thanassisfrank/pcb-touch-piano/README.md

# pcb-touch-piano

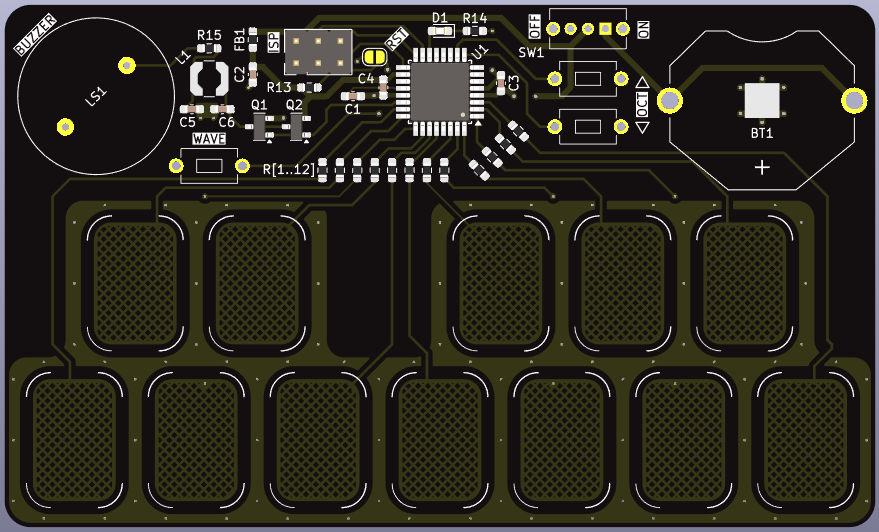
[picture p1: hardware/piano-board/piano-board.png]
The froms side of the pcb


A project to create a small piano style synth on a pcb with capacitive touch input, powered by a coin cell. The MCU is the Atmega328pb with firmware written in C.
