thanassisfrank/pcb-touch-piano/hardware/piano-board/piano-board.kicad_pcb

## KiCad design hardware/piano-board/piano-board.kicad_pcb (2024-12-03)

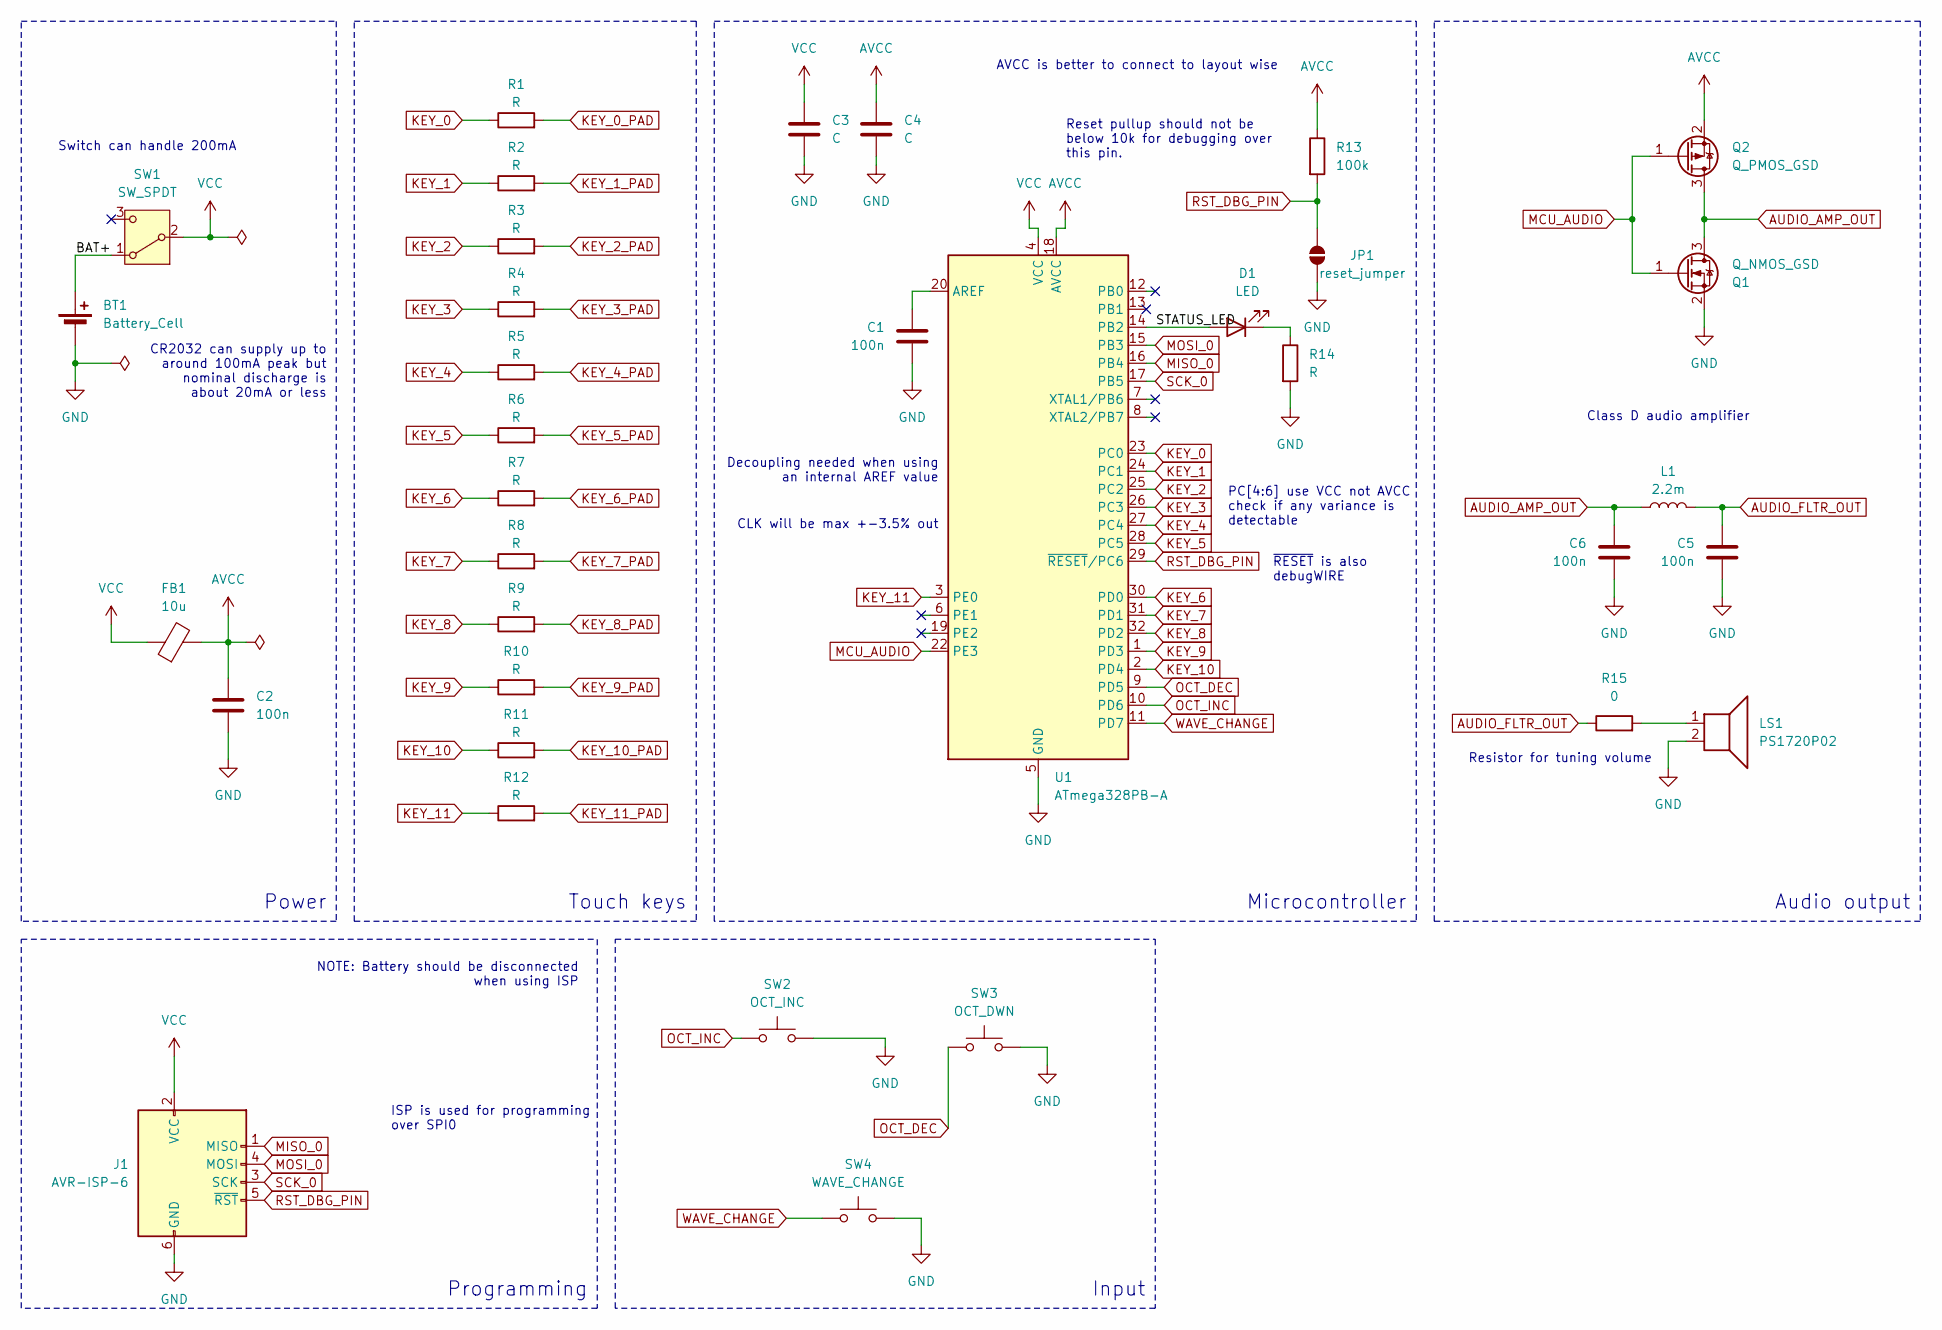
[picture p2: schematic piano-board.kicad_sch, PCB touch piano]

Parts:
BT1: Battery_Cell; MP000360
C1, C2, C5, C6: 100n; C_0603_1608Metric_Pad1.08x0.95mm_HandSolder
C3, C4: C; C_0603_1608Metric_Pad1.08x0.95mm_HandSolder
D1: LED; LED_0603_1608Metric_Pad1.05x0.95mm_HandSolder
FB1: 10u; R_0603_1608Metric_Pad0.98x0.95mm_HandSolder
J1: AVR-ISP-6; PinHeader_2x03_P2.54mm_Vertical
JP1: reset_jumper; SolderJumper-2_P1.3mm_Open_RoundedPad1.0x1.5mm
L1: 2.2m; L_Coilcraft_LPS4018
LS1: PS1720P02
Q1: Q_NMOS_GSD; SOT-23
Q2: Q_PMOS_GSD; SOT-23
R1, R2, R3, R4, R5, R6, R7, R8, R9, R10, R11, R12, R14: R; R_0603_1608Metric_Pad0.98x0.95mm_HandSolder
R13: 100k; R_0603_1608Metric_Pad0.98x0.95mm_HandSolder
R15: 0; R_0603_1608Metric_Pad0.98x0.95mm_HandSolder
SW1: SW_SPDT; SW_SPDT_TEC_1825232-1
SW2: OCT_INC; SW_PUSH_ADAFRUIT_SMALL
SW3: OCT_DWN; SW_PUSH_ADAFRUIT_SMALL
SW4: WAVE_CHANGE; SW_PUSH_ADAFRUIT_SMALL
U1: ATmega328PB-A; TQFP-32_7x7mm_P0.8mm

Connections:
/BAT+: BT1.1 (+), SW1.1 (A)
/STATUS_LED: D1.2 (A), U1.14 (PB2)
AUDIO_AMP_OUT: C6.1, L1.1, Q1.3 (D), Q2.3 (D)
AUDIO_FLTR_OUT: C5.1, L1.2, R15.1
AVCC: C2.1, C4.1, FB1.2, Q2.2 (S), R13.1, U1.18 (AVCC)
GND: BT1.2 (-), C1.1, C2.2, C3.2, C4.2, C5.2, C6.2, J1.6 (GND), JP1.1 (A), LS1.2, Q1.2 (S), R14.2, SW2.2, SW3.2, SW4.2, U1.5 (GND), U1.21 (GND)
KEY_0: R1.1, U1.23 (PC0)
KEY_0_PAD: R1.2
KEY_1: R2.1, U1.24 (PC1)
KEY_1_PAD: R2.2
KEY_2: R3.1, U1.25 (PC2)
KEY_2_PAD: R3.2
KEY_3: R4.1, U1.26 (PC3)
KEY_3_PAD: R4.2
KEY_4: R5.1, U1.27 (PC4)
KEY_4_PAD: R5.2
KEY_5: R6.1, U1.28 (PC5)
KEY_5_PAD: R6.2
KEY_6: R7.1, U1.30 (PD0)
KEY_6_PAD: R7.2
KEY_7: R8.1, U1.31 (PD1)
KEY_7_PAD: R8.2
KEY_8: R9.1, U1.32 (PD2)
KEY_8_PAD: R9.2
KEY_9: R10.1, U1.1 (PD3)
KEY_9_PAD: R10.2
KEY_10: R11.1, U1.2 (PD4)
KEY_10_PAD: R11.2
KEY_11: R12.1, U1.3 (PE0)
KEY_11_PAD: R12.2
MCU_AUDIO: Q1.1 (G), Q2.1 (G), U1.22 (PE3)
MISO_0: J1.1 (MISO), U1.16 (PB4)
MOSI_0: J1.4 (MOSI), U1.15 (PB3)
unnamed: D1.1 (K), R14.1
unnamed: LS1.1, R15.2
unnamed: C1.2, U1.20 (AREF)
OCT_DEC: SW3.1, U1.9 (PD5)
OCT_INC: SW2.1, U1.10 (PD6)
RST_DBG_PIN: J1.5 (~RST), JP1.2 (B), R13.2, U1.29 (~RESET/PC6)
SCK_0: J1.3 (SCK), U1.17 (PB5)
VCC: C3.1, FB1.1, J1.2 (VCC), SW1.2 (B), U1.4 (VCC)
WAVE_CHANGE: SW4.1, U1.11 (PD7)

Notes on the sheet:
CR2032 can supply up to around 100mA peak but nominal discharge is about 20mA or less
Input
Audio output
NOTE: Battery should be disconnected when using ISP
Programming
~{RESET} is also debugWIRE
Class D audio amplifier
Power
Touch keys
Microcontroller
Reset pullup should not be below 10k for debugging over this pin.
CLK will be max +-3.5% out
Decoupling needed when using an internal AREF value
ISP is used for programming over SPI0
Switch can handle 200mA
AVCC is better to connect to layout wise
Resistor for tuning volume
PC[4:6] use VCC not AVCC check if any variance is detectable

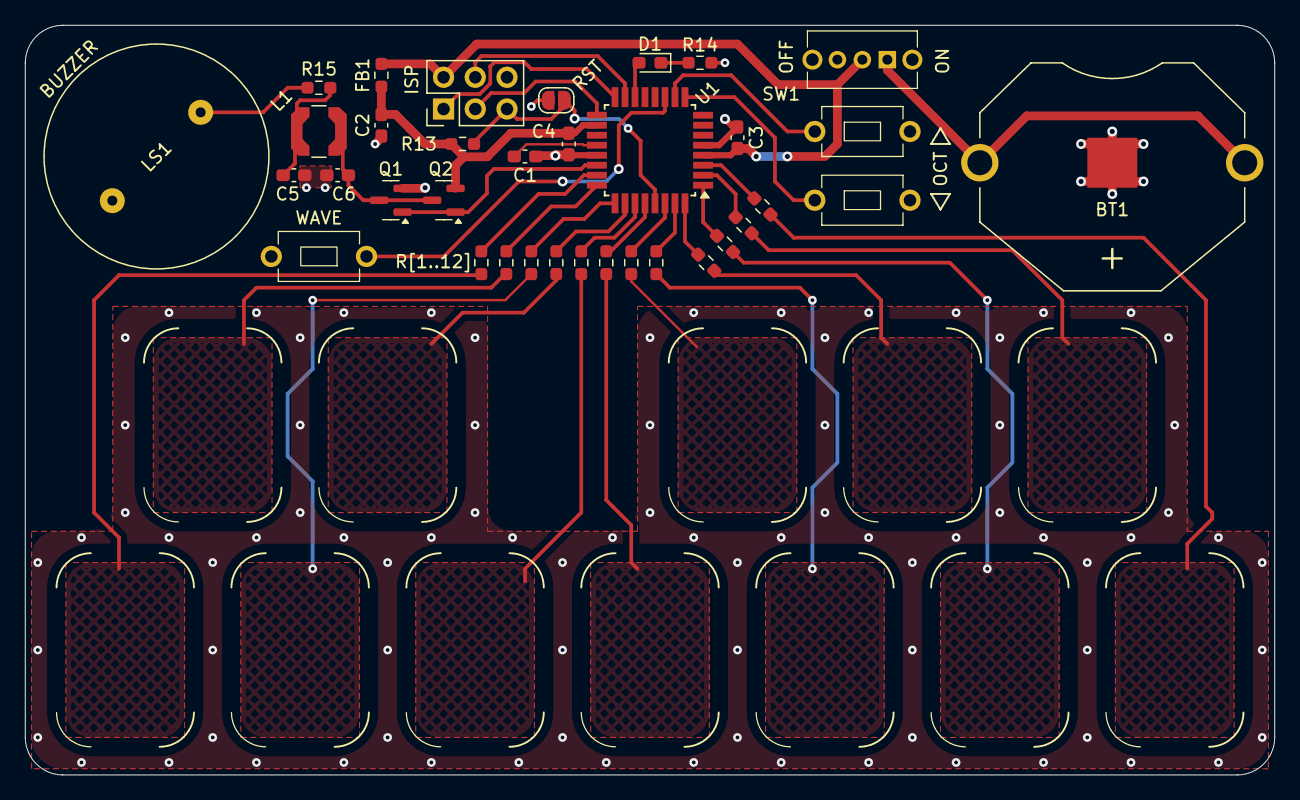
[picture p3: board piano-board.kicad_pcb from above]

Board: 2 copper layers, 100.0 x 60.0 mm, 35 parts (0 on the bottom side), 30 nets.
