thanassisfrank/pcb-touch-piano/(commit log)

2024-11-22 Create project
    [piano-board.kicad_pcb, piano-board.kicad_sch]
2024-11-23 Create initial pcb schematic
    [piano-board.kicad_sch]
2024-11-24 Design audio output on schematic
    [piano-board.kicad_sch]
2024-11-24 Assign footprints
    [piano-board.kicad_sch]
2024-11-25 Create initial board layout
    [piano-board.kicad_pcb, piano-board.kicad_sch]
2024-11-25 Improve CR2032 holder footprint
    [piano-board.kicad_pcb]
2024-11-27 Route key connections
    [piano-board.kicad_pcb, piano-board.kicad_sch]
2024-11-27 Re-assign key pins on MCU
    [piano-board.kicad_pcb, piano-board.kicad_sch]
2024-11-28 Route all signals
    [piano-board.kicad_pcb, piano-board.kicad_sch]
2024-12-02 Add status LED
    [piano-board.kicad_pcb, piano-board.kicad_sch]
2024-12-03 Polish for manufacturing
    [piano-board-B_Cu.gbr, piano-board-B_Mask.gbr, piano-board-B_Paste.gbr, piano-board-B_Silkscreen.gbr, piano-board-Edge_Cuts.gbr, piano-board-F_Cu.gbr, piano-board-F_Mask.gbr, piano-board-F_Paste.gbr]
2025-02-15 Create led flash test firmware
2025-06-19 Add interrupt detection to buttons
2025-06-19 Implement button functions with simple debouncing
2025-06-26 Remove changes to global interrupts outside of main
2025-06-26 Make capacitive key charge atomic
2025-06-26 Make DDS PWM TOP configurable
